akomakom/esp32-spa-controller/(threads)

Thread 1 (2025-04-20):

Options to be used as controller fro  Davey/Spa-Quip Spa Power PCB - SP600/601

robouden, 2025-04-20:
Hi,

Great project!!!. One question. How hard will it be to adopt the hardware and software to work with a Davey/Spa-Quip Spa Power PCB - SP600/601 setup?

Warm Regards
Rob Oudendijk

alexander-komarov-ibm, 2025-04-20:
No idea.  Is it an ESP powered board with one relay per output pin?  Then not very hard.
Ultimately the code could adapt to anything with enough effort, but I've only done just enough to make it work for my use case (a $20 ESP board with integrated relays wired as shown in the diagram here https://github.com/akomakom/esp32-spa-controller/blob/master/controller%2FREADME.md ).

akomakom, 2025-04-20:
No idea. Is it an ESP powered board with one relay per output pin? Then not very hard.
Ultimately the code could adapt to anything with enough effort, but I've only done just enough to make it work for my use case (a $20 ESP board with integrated relays wired as shown in the diagram here https://github.com/akomakom/esp32-spa-controller/blob/master/controller%2FREADME.md ).

robouden, 2025-04-20:
Thanks for the reply. No, the controller MPU is a ATMEGA08A. Closed source (as far as I know). The heater element is here [https://t.ly/puG-T](https://t.ly/puG-T) and the controller board is [https://www.hottubpartsuperstore.co.uk/davey-spa-quip-spa-power-pcb-sp600-sp601.html](https://www.hottubpartsuperstore.co.uk/davey-spa-quip-spa-power-pcb-sp600-sp601.html).

Regards
Rob
