akomakom/esp32-spa-controller/controller/controller.ino

#include <WiFi.h>
#include <WiFiClient.h>
//#include <WebServer.h>
#include <ESPmDNS.h>
#include <DNSServer.h>
#include <ArduinoJson.h>
#include "freertos/FreeRTOS.h"
#include "freertos/queue.h"

#include "secrets.h"
#include "web.h"
#include "HotTubUtils.h"
#include "ESPNowUtils.h"
#ifdef ENABLE_BLE_BTHOME
#include "BTHomeUtils.h"
#endif

// Hostname advertised over mDNS: reach the controller at http://<name>.local on the
// home network instead of hunting for a DHCP-assigned IP. Override in secrets.h.
#ifndef MDNS_HOSTNAME
#define MDNS_HOSTNAME "hottub"
#endif

// Captive-portal DNS: while the SoftAP is up we answer every DNS query with the AP's
// own IP, so joining the "hottubctl" network pops the control page up automatically
// (no need to type 192.168.4.1).
static const byte DNS_PORT = 53;
DNSServer dnsServer;

// Interval at which to publish sensor readings
#define ESP_STATUS_SEND_INTERVAL  1000

#define NTP_SYNC_INTERVAL 3600 * 1000
// If we don't get NTP sync success for this long, reboot (assume that network failed)
#define NTP_SYNC_FAIL_REBOOT_INTERVAL NTP_SYNC_INTERVAL * 24

// TimeZone rule including daylight adjustment rules (optional)
// TODO: move to Preferences
const char* time_zone = "EST5EDT,M3.2.0,M11.1.0";
const char* ntpServer1 = "pool.ntp.org";
const char* ntpServer2 = "time.nist.gov";
unsigned long  ntp_last_sync_success_time = 0;

SpaStatus spaStatus;
// Stores last time status was published on esp-now
unsigned long previousStatusSendTime = 0;

// Commands arrive on the ESP-NOW receive callback (WiFi task context). Rather than
// mutate control state there — racing the main loop — we queue them and drain in loop().
QueueHandle_t commandQueue;
#define COMMAND_QUEUE_DEPTH 10

void setDeviceTime(){
    static unsigned long lastPrint;
    bool debug = ((lastPrint + 10000) < millis());
    if (debug) {
        lastPrint = millis();
    }

    if(!getLocalTime(main_device_time, 9)){
        if ((lastPrint + 10000) < millis()) {
            Serial.println("No time available (yet)");
            lastPrint = millis();
        }
        return;
    }
    if (debug) {
        Serial.println(main_device_time, "Determined time: %A, %B %d %Y %H:%M:%S");
    }
//    static time_t t = mktime(main_device_time);
//    struct timeval now = { .tv_sec = t };
    // this seems to be causing time to stand still:
//    settimeofday(&now, NULL); // is this even useful?

    // calculate timezone offset

    static struct tm  linfo, ginfo;
    static time_t  rawt;
    time( &rawt );
    gmtime_r( &rawt, &ginfo);
    localtime_r( &rawt, &linfo);

    time_t g = mktime(&ginfo);
    time_t l = mktime(&linfo);

    static int    offsetSeconds = difftime( l, g );
    static int    offsetHours   = (int)offsetSeconds /(60*60);
    // for our globals, we care about actual time offset (including DST)
    timezone_offset = linfo.tm_isdst ? offsetSeconds + 3600 : offsetSeconds;
    // print out debugs every minute
    if ((lastPrint + 60000) < millis()) {
//        Serial.printf("Setting time to %s\n", asctime(main_device_time));
        Serial.printf("Timezone offset is %d hour%s (%d seconds), %s  current offset is %d hour%s (%d seconds)\n\n",
                      offsetHours,
                      (offsetHours > 1 || offsetHours < -1) ? "s" : "",
                      offsetSeconds,
                      linfo.tm_isdst ? "DST in effect" : "DST not in effect",
                      linfo.tm_isdst ? offsetHours + 1 : offsetHours,
                      ((offsetHours + 1) > 1 || (offsetHours + 1) < -1) ? "s" : "",
                      timezone_offset
                      );

//        Serial.printf("Device time: %d\n", rawt);
        lastPrint = millis();
    }
}

// Callback function (get's called when time adjusts via NTP)
void timeavailable(struct timeval *t)
{
    Serial.println("Got time adjustment from NTP!");
    setDeviceTime();
    ntp_last_sync_success_time = millis();
}

void setupNTP() {
    sntp_set_time_sync_notification_cb( timeavailable );
    sntp_set_sync_interval(NTP_SYNC_INTERVAL) ; // This is probably default, but I want to make sure it's set to an hour.
    /**
     * NTP server address could be aquired via DHCP,
     *
     * NOTE: This call should be made BEFORE esp32 aquires IP address via DHCP,
     * otherwise SNTP option 42 would be rejected by default.
     * NOTE: configTime() function call if made AFTER DHCP-client run
     * will OVERRIDE aquired NTP server address
     */
//    sntp_servermode_dhcp(1);    // (optional)

    /**
     * This will set configured ntp servers and constant TimeZone/daylightOffset
     * should be OK if your time zone does not need to adjust daylightOffset twice a year,
     * in such a case time adjustment won't be handled automagicaly.
     */
//    configTime(gmtOffset_sec, daylightOffset_sec, ntpServer1, ntpServer2);

    /**
     * A more convenient approach to handle TimeZones with daylightOffset
     * would be to specify a environmnet variable with TimeZone definition including daylight adjustmnet rules.
     * A list of rules for your zone could be obtained from https://github.com/esp8266/Arduino/blob/master/cores/esp8266/TZ.h
     */
    configTzTime(time_zone, ntpServer1, ntpServer2);
}

void setupWIFI() {

    // delete old config
    WiFi.disconnect(true);

    delay(1000);

    WiFi.onEvent(WiFiStationConnected, WiFiEvent_t::ARDUINO_EVENT_WIFI_STA_CONNECTED);
    WiFi.onEvent(WiFiGotIP, WiFiEvent_t::ARDUINO_EVENT_WIFI_STA_GOT_IP);
    WiFi.onEvent(WiFiStationDisconnected, WiFiEvent_t::ARDUINO_EVENT_WIFI_STA_DISCONNECTED);

    // To support ESP-NOW
    // Set the device as a Station and Soft Access Point simultaneously
    WiFi.mode(WIFI_AP_STA);
    // Advertise a DHCP hostname *before* connecting so the router registers it. Many
    // home routers then resolve http://<name> (or <name>.lan) on the LAN — which,
    // unlike mDNS/.local, actually works from Android and Linux browsers.
    WiFi.setHostname(MDNS_HOSTNAME);
    // Connect to WiFi network
    if (app_preferences.isKey("wifi_ssid")) {
      WiFi.begin(app_preferences.getString("wifi_ssid"), app_preferences.getString("wifi_pass"));
      Serial.printf("WiFi begin called, connecting to %s", app_preferences.getString("wifi_ssid").c_str());
    } else {
      Serial.println("WiFi not configured yet, not starting.");
    }
    delay(1000);
}

void setupSoftAP() {
    //
    WiFi.softAP(SOFTAP_WIFI_NAME, SOFTAP_WIFI_PASS);
    Serial.printf("Software Access Point available at %s/%s", SOFTAP_WIFI_NAME, SOFTAP_WIFI_PASS == NULL ? "(NOT SET)": SOFTAP_WIFI_PASS);

    // Resolve every hostname to the SoftAP IP so phones detect a captive portal and
    // open the control/setup page automatically on joining the network.
    dnsServer.setErrorReplyCode(DNSReplyCode::NoError);
    dnsServer.start(DNS_PORT, "*", WiFi.softAPIP());
    Serial.printf("Captive portal DNS started on %s\n", WiFi.softAPIP().toString().c_str());
}

//
//void handleRequest()
//{
//  if (server.method() == HTTP_POST) {
//    strncpy(wiFiCredentials.ssid, server.arg("ssid").c_str(), sizeof(wiFiCredentials.ssid));
//    strncpy(wiFiCredentials.password, server.arg("password").c_str(), sizeof(wiFiCredentials.password));
//
//    wiFiCredentials.ssid[server.arg("ssid").length()] = wiFiCredentials.password[server.arg("password").length()] = 0;
//
//    EEPROM.put(0, wiFiCredentials);
//    EEPROM.commit();
//
//    const char * content = "<html><head> <link rel=\"stylesheet\" href=\"https://netdna.bootstrapcdn.com/bootstrap/3.0.2/css/bootstrap.min.css\"> <style>body{background: #eee !important;}.wrapper{margin-top: 80px; margin-bottom: 80px;}.form-signin, .result-message{max-width: 380px; padding: 15px 35px 45px; margin: 0 auto; background-color: #fff; border: 1px solid rgba(0, 0, 0, 0.1);}.form-signin .form-signin-heading{margin-bottom: 30px;}.form-signin .form-control{position: relative; font-size: 16px; height: auto; padding: 10px; -webkit-box-sizing: border-box; -moz-box-sizing: border-box; box-sizing: border-box;}.form-signin .form-control:focus{z-index: 2;}.form-signin input[type=text]{margin-bottom: -1px; border-bottom-left-radius: 0; border-bottom-right-radius: 0;}.form-signin input[type=password]{margin-bottom: 20px; border-top-left-radius: 0; border-top-right-radius: 0;}.result-message{text-align: center;}</style></head><body> <div class=\"wrapper\"> <div class=\"result-message\"> The Wi-Fi credentials have been stored. <br/> Please reboot the device! </div></div></body></html> ";
//    server.send(200, "text/html", content);
//  } else {
//    const char * formHtml = "<html><head> <link rel=\"stylesheet\" href=\"https://netdna.bootstrapcdn.com/bootstrap/3.0.2/css/bootstrap.min.css\"> <style>body{background: #eee !important;}.wrapper{margin-top: 80px; margin-bottom: 80px;}.form-signin{max-width: 380px; padding: 15px 35px 45px; margin: 0 auto; background-color: #fff; border: 1px solid rgba(0, 0, 0, 0.1);}.form-signin .form-signin-heading{margin-bottom: 30px;}.form-signin .form-control{position: relative; font-size: 16px; height: auto; padding: 10px; -webkit-box-sizing: border-box; -moz-box-sizing: border-box; box-sizing: border-box;}.form-signin .form-control:focus{z-index: 2;}.form-signin input[type=text]{margin-bottom: -1px; border-bottom-left-radius: 0; border-bottom-right-radius: 0;}.form-signin input[type=password]{margin-bottom: 20px; border-top-left-radius: 0; border-top-right-radius: 0;}</style></head><body> <div class=\"wrapper\"> <form class=\"form-signin\" method=\"POST\"> <h2 class=\"form-signin-heading\">Connect To Wi-Fi</h2> <input type=\"text\" class=\"form-control\" name=\"ssid\" placeholder=\"SSID\" required=\"\" autofocus=\"\"/> <input type=\"password\" class=\"form-control\" name=\"password\" placeholder=\"Password\" required=\"\"/> <button class=\"btn btn-lg btn-primary btn-block\" type=\"submit\">Save</button> </form> </div></body></html> ";
//    server.send(200, "text/html", formHtml);
//  }
//}

void setup(void) {
    Serial.begin(115200);

    if (!app_preferences.begin(PREFERENCES_NAME)) {
        Serial.println("Unable to open preferences");
    }
    spaWinterized = app_preferences.getBool("winterized", false); // persists across reboots
    if (spaWinterized) {
        Serial.println("WINTERIZED mode is ON at boot: all controls forced off.");
    }

    commandQueue = xQueueCreate(COMMAND_QUEUE_DEPTH, sizeof(struct_command));

    setupNTP();
    setupSoftAP();
    setupWIFI();

    // mDNS is (re)started from the WiFiGotIP event, once the STA actually has an IP,
    // so the responder binds to the LAN interface and not just the SoftAP.

    SPIFFS.begin();

    server.on("/status", HTTP_GET, []() {
        spaStatus.updateStatusString();
        sendJSONResponse(spaStatus.statusString);
    });

    server.on("/toggle", HTTP_POST, []() {
        const char *response = WEB_RESPONSE_OK;
        try {
            spaStatus.findByName(server.arg("control").c_str())->toggle();
            previousStatusSendTime = 0; // update all others
            sendJSONResponse(WEB_RESPONSE_OK);
        } catch (std::invalid_argument &e) {
            sendJSONResponse(e.what(), 500);
        }
    });
    server.on("/override", HTTP_POST, []() {
        try {
            // seconds relative to current time
            time_t start    = (time_t)server.arg("start").toInt();
            time_t duration = (time_t)server.arg("duration").toInt();
            u_int8_t value = (u_int8_t)server.arg("value").toInt();
            spaStatus.findByName(server.arg("control").c_str())->applyUserValue(start, duration, value);
            previousStatusSendTime = 0; //update all others
            sendJSONResponse(WEB_RESPONSE_OK);
        } catch (std::invalid_argument &e) {
            sendJSONResponse(e.what(), 500);
        }
    });
    // Display/temperature unit is authoritative on the controller and pushed to the
    // display over ESP-NOW. 0 = Fahrenheit, 1 = Celsius.
    server.on("/tempUnit", HTTP_POST, []() {
        u_int8_t unit = (u_int8_t)server.arg("unit").toInt() ? 1 : 0;
        app_preferences.putUChar("temp_unit", unit);
        previousStatusSendTime = 0; // push the new unit to peers promptly
        sendJSONResponse(WEB_RESPONSE_OK);
    });
    // Winterized mode: force all controls off (ignoring schedules), persisted across
    // reboots and pushed to the display over ESP-NOW.
    server.on("/winterize", HTTP_POST, []() {
        spaWinterized = server.arg("on").toInt() ? true : false;
        app_preferences.putBool("winterized", spaWinterized);
        previousStatusSendTime = 0; // push the new state to peers promptly
        sendJSONResponse(WEB_RESPONSE_OK);
    });
    server.on("/configureControl", HTTP_GET, []() {
        SpaControl *control = spaStatus.findByName(server.arg("control").c_str());
        control->updateConfigJsonString();
        sendJSONResponse(control->configString);
    });
    // Body: control=<name>, overrideDefaultDurationSeconds=<n>, and periods=<json array>
    // e.g. periods=[{"startHour":0,"onMinutes":5,"cycleMinutes":15,"onValue":1,"offValue":0}, ...]
    server.on("/configureControl", HTTP_POST, []() {
        try {
            SpaControl *control = spaStatus.findByName(server.arg("control").c_str());

            StaticJsonDocument<800> doc;
            DeserializationError err = deserializeJson(doc, server.arg("periods"));
            if (err) {
                sendJSONResponse("Invalid periods JSON", 400);
                return;
            }
            JsonArray arr = doc.as<JsonArray>();
            SpaSchedulePeriod periods[MAX_SCHEDULE_PERIODS];
            u_int8_t count = 0;
            for (JsonObject o : arr) {
                if (count >= MAX_SCHEDULE_PERIODS) break;
                periods[count].startHour    = (u_int8_t) o["startHour"].as<int>();
                periods[count].onMinutes    = (u_int16_t)o["onMinutes"].as<int>();
                periods[count].cycleMinutes = (u_int16_t)o["cycleMinutes"].as<int>();
                periods[count].onValue      = (u_int8_t) o["onValue"].as<int>();
                periods[count].offValue     = (u_int8_t) o["offValue"].as<int>();
                count++;
            }
            if (count >= 1) {
                control->setSchedule(periods, count); // sorts, clamps, forces first to 00:00
            }
            if (server.hasArg("overrideDefaultDurationSeconds")) {
                control->scheduleSettings.overrideDefaultDurationSeconds =
                        (u_int32_t)server.arg("overrideDefaultDurationSeconds").toInt();
            }
            control->persist();
            previousStatusSendTime = 0; // update others
            sendJSONResponse(WEB_RESPONSE_OK);
        } catch (std::invalid_argument &e) {
            sendJSONResponse(e.what(), 500);
        }
    });

    setupServerDefaultActions();
    server.begin();

    spaStatus.setup();
    ESPNowUtils::setup();
#ifdef ENABLE_BLE_BTHOME
    // BLE BTHome broadcast of telemetry (water temp for now). Started after WiFi/ESP-NOW
    // so the radio coexistence layer is already up. See BTHomeUtils.h. Opt-in build flag.
    BTHomeUtils::setup("Hot Tub");
#endif
    ESPNowUtils::registerCommandCallBackHandler((ESPNowUtils::hot_tub_command_recv_callback)espnowCommandReceived);
    ESPNowUtils::registerPairingCallBackHandler((ESPNowUtils::hot_tub_paired_callback)peerAdded);

}

void loop(void) {
    static unsigned long lastHttpReportTime = 0;
    static unsigned long lastTimeUpdate = 0;

    // setDeviceTime() calls getLocalTime(..., 9), which blocks for the full 9ms whenever
    // the clock is not NTP-synced (e.g. during SoftAP setup, before any home WiFi is set).
    // Running it every loop throttles the loop to ~100Hz, which starves the captive-portal
    // DNS and single-threaded WebServer once wildcard DNS funnels all client traffic at us.
    // Second-resolution time is plenty for scheduling, so update it at most once a second.
    if (millis() - lastTimeUpdate >= 1000) {
        lastTimeUpdate = millis();
        setDeviceTime();
    }
    dnsServer.processNextRequest();
    server.handleClient();
    processCommandQueue();
    spaStatus.loop();
    ESPNowUtils::loop();
    sendStatus();
#ifdef ENABLE_BLE_BTHOME
    // Feed the latest water-temp reading to the BLE beacon; loop() throttles publishing.
    BTHomeUtils::setWaterTemp(spaStatus.temperatureUtils.getTempF(0),
                              spaStatus.temperatureUtils.isValid(0));
    BTHomeUtils::loop();
#endif
    yield();
//    sleep(5);

#ifdef REPORT_SEND_FREQUENCY
    if (WiFi.status() == WL_CONNECTED && (millis() - lastHttpReportTime) > REPORT_SEND_FREQUENCY) {
      sendStatusViaHttp(REPORT_SEND_URL, spaStatus.statusString);
      lastHttpReportTime = millis();
    }
#endif
    // reboot check
    if ((millis() - ntp_last_sync_success_time) > NTP_SYNC_FAIL_REBOOT_INTERVAL) {
        Serial.printf("We have not seen an NTP update in over %d, assuming network broke, rebooting", NTP_SYNC_FAIL_REBOOT_INTERVAL);
        ESP.restart();
    }
}

void peerAdded(struct_pairing pairing) {
    previousStatusSendTime = 0; // update others
}

void sendStatus() {
    unsigned long currentMillis = millis();
    if (currentMillis - previousStatusSendTime >= ESP_STATUS_SEND_INTERVAL) {
        // Save the last time a new reading was published
        previousStatusSendTime = currentMillis;

        ESPNowUtils::outgoingStatusServer.time = mktime(main_device_time);
        ESPNowUtils::outgoingStatusServer.tz_offset = timezone_offset;
        // Native unit is Fahrenheit; the display converts for presentation.
        ESPNowUtils::outgoingStatusServer.water_temp = spaStatus.temperatureUtils.getTempF(0);
        ESPNowUtils::outgoingStatusServer.temp_unit = app_preferences.getUChar("temp_unit", 0);
        ESPNowUtils::outgoingStatusServer.winterized = spaWinterized ? 1 : 0;
        ESPNowUtils::outgoingStatusServer.control_count = spaStatus.controls.size();
        ESPNowUtils::outgoingStatusServer.touchscreen_timeout = 300;

        // TODO:
//        ESPNowUtils::outgoingStatusServer.server_name =

        ESPNowUtils::sendStatusServer();

        for (int i = 0 ; i < spaStatus.controls.size() ; i++) {
            yield(); // this really slows down updates
            delay(1);
            SpaControl* control = spaStatus.controls[i];
            ESPNowUtils::outgoingStatusControl.control_id = i;
            ESPNowUtils::outgoingStatusControl.min = control->min;
            ESPNowUtils::outgoingStatusControl.max = control->max;
            strcpy(ESPNowUtils::outgoingStatusControl.type, control->type);
            strcpy(ESPNowUtils::outgoingStatusControl.name, control->name);
            ESPNowUtils::outgoingStatusControl.ORT = control->getOverrideScheduleRemainingTime();
            ESPNowUtils::outgoingStatusControl.DO = control->scheduleSettings.overrideDefaultDurationSeconds;
            ESPNowUtils::outgoingStatusControl.EL = control->getOverrideScheduleElapsedTime();

            ESPNowUtils::outgoingStatusControl.value = control->getEffectiveValue();
            ESPNowUtils::outgoingStatusControl.e_value = control->getOnState();

            ESPNowUtils::sendStatusControl();
        }
    }
}

/**
 * Handle incoming commands received via ESP-NOW.
 * Runs in the WiFi task context, so we only enqueue here and apply from loop().
 * @param command
 */
void espnowCommandReceived(struct_command *command) {
    Serial.print("Received command: control=");Serial.print(command->control_id);
    Serial.print(" value=");Serial.print(command->value);
    Serial.print(" end=");Serial.print(command->end);
    Serial.println();

    if (commandQueue != NULL) {
        xQueueSend(commandQueue, command, 0); // copies the struct; drop if queue is full
    }
}

/**
 * Drain and apply any commands queued by the ESP-NOW receive callback.
 * Runs on the main loop, so it is safe to mutate control state here.
 */
void processCommandQueue() {
    struct_command command;
    while (commandQueue != NULL && xQueueReceive(commandQueue, &command, 0) == pdTRUE) {
        if (command.control_id >= spaStatus.controls.size()) {
            Serial.printf("Ignoring command for out-of-range control_id %d\n", command.control_id);
            continue;
        }
        previousStatusSendTime = 0; // update others
        try {
            spaStatus.controls[command.control_id]->applyUserValue(
                    command.start,
                    command.end,
                    command.value
            );
        } catch (std::invalid_argument &e) {
            Serial.printf("Rejected command for control %d: %s\n", command.control_id, e.what());
        }
    }
}


// WIFI:

void WiFiStationConnected(WiFiEvent_t event, WiFiEventInfo_t info){
    Serial.println("Connected to AP successfully!");
    Serial.println("");

    Serial.print("Connected to ");
    Serial.print(app_preferences.getString("wifi_ssid"));
}

void WiFiGotIP(WiFiEvent_t event, WiFiEventInfo_t info){
    Serial.println("WiFi connected");
    Serial.println("IP address: ");
    Serial.println(WiFi.localIP());

    // (Re)start mDNS now that the STA has an IP so the responder binds to the LAN
    // interface. Restart on every reconnect so it re-announces after the link drops.
    static bool mdnsStarted = false;
    if (mdnsStarted) {
        MDNS.end();
    }
    if (MDNS.begin(MDNS_HOSTNAME)) {
        MDNS.addService("http", "tcp", 80);
        mdnsStarted = true;
        Serial.printf("mDNS responder started: http://%s.local\n", MDNS_HOSTNAME);
    } else {
        Serial.println("Error setting up mDNS responder!");
    }
}

void WiFiStationDisconnected(WiFiEvent_t event, WiFiEventInfo_t info){
    Serial.println("Disconnected from WiFi access point");
    Serial.print("WiFi lost connection. Reason: ");
    Serial.println(info.wifi_sta_disconnected.reason);
    Serial.println("Trying to Reconnect");
    WiFi.begin(app_preferences.getString("wifi_ssid"), app_preferences.getString("wifi_pass"));

}
