akomakom/esp32-spa-controller/controller/web.cpp

#include <WiFi.h>
#include "core.h"
#include "web.h"
#include "secrets.h"

// Credentials for firmware / filesystem / WiFi endpoints. Override in secrets.h.
#ifndef OTA_AUTH_USER
#define OTA_AUTH_USER "admin"
#endif
#ifndef OTA_AUTH_PASS
#define OTA_AUTH_PASS "admin"
#endif

// Gate sensitive endpoints behind HTTP Basic auth. Returns false (and sends a 401)
// when the request is not authenticated, so callers can simply `if (!requireAuth()) return;`.
bool requireAuth() {
    if (!server.authenticate(OTA_AUTH_USER, OTA_AUTH_PASS)) {
        server.requestAuthentication();
        return false;
    }
    return true;
}

// Hostname advertised over mDNS (keep in sync with controller.ino). Requests whose
// Host header matches this, the SoftAP IP, or the STA IP are treated as direct visits;
// anything else arriving on the SoftAP is an OS captive-portal probe.
#ifndef MDNS_HOSTNAME
#define MDNS_HOSTNAME "hottub"
#endif

const char *WEB_RESPONSE_OK = R"({ "success": true })";
const char *WEB_RESPONSE_FAIL = R"({ "success": false })";

// When a phone joins the SoftAP, the OS probes a known URL (captive.apple.com,
// connectivitycheck.gstatic.com, msftconnecttest.com, ...). Because our captive DNS
// resolves every name to the AP IP, those probes land here with a foreign Host header.
// Answering with a 302 to the control page makes the OS pop up the captive-portal browser
// automatically. Returns true if it handled (redirected) the request.
bool handleCaptivePortal() {
    String host = server.hostHeader();
    String apIP = WiFi.softAPIP().toString();
    String staIP = WiFi.localIP().toString();
    if (host == apIP ||
        (staIP.length() && staIP != "0.0.0.0" && host == staIP) ||
        host.equalsIgnoreCase(String(MDNS_HOSTNAME) + ".local")) {
        return false; // direct visit to a known address — serve normally
    }
    server.sendHeader("Location", String("http://") + apIP + "/", true);
    server.send(302, "text/plain", "");
    return true;
}

/*
 * Login page
 */

const char *WEBPAGE_LOGIN =
        "<form name='loginForm'>"
        "<table width='20%' bgcolor='A09F9F' align='center'>"
        "<tr>"
        "<td colspan=2>"
        "<center><font size=4><b>ESP32 Login Page AKOM</b></font></center>"
        "<br>"
        "</td>"
        "<br>"
        "<br>"
        "</tr>"
        "<tr>"
        "<td>Username:</td>"
        "<td><input type='text' size=25 name='userid'><br></td>"
        "</tr>"
        "<br>"
        "<br>"
        "<tr>"
        "<td>Password:</td>"
        "<td><input type='Password' size=25 name='pwd'><br></td>"
        "<br>"
        "<br>"
        "</tr>"
        "<tr>"
        "<td><input type='submit' onclick='check(this.form)' value='Login'></td>"
        "</tr>"
        "</table>"
        "</form>"
        "<script>"
        "function check(form)"
        "{"
        "if(form.userid.value=='admin' && form.pwd.value=='admin')"
        "{"
        "window.open('/serverIndex')"
        "}"
        "else"
        "{"
        " alert('Error Password or Username')/*displays error message*/"
        "}"
        "}"
        "</script>";

/*
 * Server Index Page
 */

const char *WEBPAGE_UPDATE =
        "<script src='https://ajax.googleapis.com/ajax/libs/jquery/3.2.1/jquery.min.js'></script>"
        "<form method='POST' action='#' enctype='multipart/form-data' id='upload_form'>"
        "<input type='file' name='update'>"
        "<input type='submit' value='Update'>"
        "</form>"
        "<div id='prg'>progress: 0%</div>"
        "<script>"
        "$('form').submit(function(e){"
        "e.preventDefault();"
        "var form = $('#upload_form')[0];"
        "var data = new FormData(form);"
        " $.ajax({"
        "url: '/update',"
        "type: 'POST',"
        "data: data,"
        "contentType: false,"
        "processData:false,"
        "xhr: function() {"
        "var xhr = new window.XMLHttpRequest();"
        "xhr.upload.addEventListener('progress', function(evt) {"
        "if (evt.lengthComputable) {"
        "var per = evt.loaded / evt.total;"
        "$('#prg').html('progress: ' + Math.round(per*100) + '%');"
        "}"
        "}, false);"
        "return xhr;"
        "},"
        "success:function(d, s) {"
        "console.log('success!')"
        "},"
        "error: function (a, b, c) {"
        "}"
        "});"
        "});"
        "</script>";

//holds the current upload
File fsUploadFile;

void sendJSONResponse(const char *content) {
    sendJSONResponse(content, 200);
}

void sendJSONResponse(const char *content, int code) {
    server.sendHeader("Connection", "close");
    server.send(code, "application/json", content);
}

void sendHTMLResponse(const char *content) {
    server.sendHeader("Connection", "close");
    server.send(200, "text/html", content);
}

void returnFail(String msg) {
    server.send(500, "text/plain", msg + "\r\n");
}

String getContentType(String filename){
    if(server.hasArg("download")) return "application/octet-stream";
    else if(filename.endsWith(".htm")) return "text/html";
    else if(filename.endsWith(".html")) return "text/html";
    else if(filename.endsWith(".css")) return "text/css";
    else if(filename.endsWith(".js")) return "application/javascript";
    else if(filename.endsWith(".png")) return "image/png";
    else if(filename.endsWith(".gif")) return "image/gif";
    else if(filename.endsWith(".jpg")) return "image/jpeg";
    else if(filename.endsWith(".ico")) return "image/x-icon";
    else if(filename.endsWith(".xml")) return "text/xml";
    else if(filename.endsWith(".pdf")) return "application/x-pdf";
    else if(filename.endsWith(".zip")) return "application/x-zip";
    else if(filename.endsWith(".gz")) return "application/x-gzip";
    return "text/plain";
}

bool handleFileRead(String path){
    Serial.println("handleFileRead: " + path);
    if(path.endsWith("/")) path += "index.html";
    String contentType = getContentType(path);
    String pathWithGz = path + ".gz";
    if(SPIFFS.exists(pathWithGz) || SPIFFS.exists(path)){
        if(SPIFFS.exists(pathWithGz))
            path += ".gz";
        File file = SPIFFS.open(path, "r");
        size_t sent = server.streamFile(file, contentType);
        file.close();
        return true;
    }
    return false;
}

void handleFileUpload(){
    if(server.uri() != "/edit") return;
    if(!server.authenticate(OTA_AUTH_USER, OTA_AUTH_PASS)) return;
    HTTPUpload& upload = server.upload();
    if(upload.status == UPLOAD_FILE_START){
        String filename = upload.filename;
        if(!filename.startsWith("/")) filename = "/"+filename;
        DBG_OUTPUT_PORT.print("handleFileUpload Name: "); DBG_OUTPUT_PORT.println(filename);
        fsUploadFile = SPIFFS.open(filename, "w");
        filename = String();
    } else if(upload.status == UPLOAD_FILE_WRITE){
        //DBG_OUTPUT_PORT.print("handleFileUpload Data: "); DBG_OUTPUT_PORT.println(upload.currentSize);
        if(fsUploadFile)
            fsUploadFile.write(upload.buf, upload.currentSize);
    } else if(upload.status == UPLOAD_FILE_END){
        if(fsUploadFile)
            fsUploadFile.close();
        DBG_OUTPUT_PORT.print("handleFileUpload Size: "); DBG_OUTPUT_PORT.println(upload.totalSize);
    }
}

void handleFileDelete(){
    if(server.args() == 0) return server.send(500, "text/plain", "BAD ARGS");
    String path = server.arg(0);
    DBG_OUTPUT_PORT.println("handleFileDelete: " + path);
    if(path == "/")
        return server.send(500, "text/plain", "BAD PATH");
    if(!SPIFFS.exists(path))
        return server.send(404, "text/plain", "FileNotFound");
    SPIFFS.remove(path);
    server.send(200, "text/plain", "");
    path = String();
}

void handleFileCreate(){
    if(server.args() == 0)
        return server.send(500, "text/plain", "BAD ARGS");
    String path = server.arg(0);
    DBG_OUTPUT_PORT.println("handleFileCreate: " + path);
    if(path == "/")
        return server.send(500, "text/plain", "BAD PATH");
    if(SPIFFS.exists(path))
        return server.send(500, "text/plain", "FILE EXISTS");
    File file = SPIFFS.open(path, "w");
    if(file)
        file.close();
    else
        return server.send(500, "text/plain", "CREATE FAILED");
    server.send(200, "text/plain", "");
    path = String();
}

void handleFileList() {
    if(!server.hasArg("dir")) {
        returnFail("BAD ARGS");
        return;
    }
    String path = server.arg("dir");
    if(path != "/" && !SPIFFS.exists((char *)path.c_str())) {
        returnFail("BAD PATH");
        return;
    }
    File dir = SPIFFS.open((char *)path.c_str());
    path = String();
    if(!dir.isDirectory()){
        dir.close();
        returnFail("NOT DIR");
        return;
    }
    dir.rewindDirectory();

    String output = "[";
    for (int cnt = 0; true; ++cnt) {
        File entry = dir.openNextFile();
        if (!entry)
            break;

        if (cnt > 0)
            output += ',';

        output += "{\"type\":\"";
        output += (entry.isDirectory()) ? "dir" : "file";
        output += "\",\"name\":\"";
        // Ignore '/' prefix
//        output += entry.name()+1;
        output += entry.name();
        output += "\"";
        output += "}";
        entry.close();
    }
    output += "]";
    server.send(200, "text/json", output);
    dir.close();
}

void listDir(fs::FS &fs, const char * dirname, uint8_t levels) {
    DBG_OUTPUT_PORT.printf("Listing directory: %s\n", dirname);

    File root = fs.open(dirname);
    if (!root) {
        DBG_OUTPUT_PORT.println("Failed to open directory");
        return;
    }
    if (!root.isDirectory()) {
        DBG_OUTPUT_PORT.println("Not a directory");
        return;
    }

    File file = root.openNextFile();
    while (file) {
        if (file.isDirectory()) {
            DBG_OUTPUT_PORT.print("  DIR : ");
            DBG_OUTPUT_PORT.println(file.name());
            if (levels) {
                listDir(fs, file.name(), levels - 1);
            }
        } else {
            DBG_OUTPUT_PORT.print("  FILE: ");
            DBG_OUTPUT_PORT.print(file.name());
            DBG_OUTPUT_PORT.print("  SIZE: ");
            DBG_OUTPUT_PORT.println(file.size());
        }
        file = root.openNextFile();
    }
}

void setupServerDefaultActions() {
    server.on("/serverIndex", HTTP_GET, []() {
        if (!requireAuth()) return;
        sendHTMLResponse(WEBPAGE_UPDATE);
    });
    server.on("/update", HTTP_GET, []() {
        if (!requireAuth()) return;
        sendHTMLResponse(WEBPAGE_UPDATE);
    });
    /*handling uploading firmware file */
    server.on("/update", HTTP_POST, []() {
        if (!requireAuth()) return;
        server.sendHeader("Connection", "close");
        server.send(200, "text/plain", (Update.hasError()) ? "FAIL" : "OK");
        ESP.restart();
    }, []() {
        // Runs while the request body streams in, before the completion handler above.
        // Refuse to touch flash unless authenticated.
        if (!server.authenticate(OTA_AUTH_USER, OTA_AUTH_PASS)) return;
        HTTPUpload &upload = server.upload();
        if (upload.status == UPLOAD_FILE_START) {
            Serial.printf("Update: %s\n", upload.filename.c_str());
            if (!Update.begin(UPDATE_SIZE_UNKNOWN)) { //start with max available size
                Update.printError(Serial);
            }
        } else if (upload.status == UPLOAD_FILE_WRITE) {
            /* flashing firmware to ESP*/
            if (Update.write(upload.buf, upload.currentSize) != upload.currentSize) {
                Update.printError(Serial);
            }
        } else if (upload.status == UPLOAD_FILE_END) {
            if (Update.end(true)) { //true to set the size to the current progress
                Serial.printf("Update Success: %u\nRebooting...\n", upload.totalSize);
            } else {
                Update.printError(Serial);
            }
        }
    });

    //load editor
    server.on("/edit", HTTP_GET, [](){
        if (!requireAuth()) return;
        if(!handleFileRead("/edit.htm")) server.send(404, "text/plain", "FileNotFound");
    });
    //create file
    server.on("/edit", HTTP_PUT, [](){ if (!requireAuth()) return; handleFileCreate(); });
    //delete file
    server.on("/edit", HTTP_DELETE, [](){ if (!requireAuth()) return; handleFileDelete(); });
    //first callback is called after the request has ended with all parsed arguments
    //second callback handles file uploads at that location
    server.on("/edit", HTTP_POST, [](){
        if (!requireAuth()) return;
        server.send(200, "text/plain", "");
    }, handleFileUpload);


    server.on("/list", HTTP_GET, [](){ if (!requireAuth()) return; handleFileList(); });

    server.on("/configureWifi", HTTP_POST, []() {
      if (!requireAuth()) return;
      Serial.printf("Configuring WiFi to %s/%s", server.arg("wifi_ssid").c_str(), server.arg("wifi_pass").c_str());
      app_preferences.putString("wifi_ssid", server.arg("wifi_ssid").c_str());
      app_preferences.putString("wifi_pass", server.arg("wifi_pass").c_str());
      Serial.printf("WIFI Configuration set to %s/%s, restarting", app_preferences.getString("wifi_ssid").c_str(), app_preferences.getString("wifi_pass").c_str());
      ESP.restart();
    });

    //called when the url is not defined here
    //use it to load content from SPIFFS
    server.onNotFound([](){
        // Redirect OS captive-portal probes to the control page (SoftAP visitors).
        if (handleCaptivePortal()) return;
        if(!handleFileRead(server.uri()))
            server.send(404, "text/plain", "FileNotFound");
    });
}


void sendStatusViaHttp(char* serverUrl, char* statusString) {

      httpClient.begin(serverUrl);  // HTTPS handled automatically
      httpClient.addHeader("Content-Type", "application/json");  // Specify JSON format

      // Send POST request
      int httpResponseCode = httpClient.POST(statusString);

      if (httpResponseCode > 0) {
          Serial.printf("HTTP Response code: %d\n", httpResponseCode);
          String response = httpClient.getString();
          Serial.println("Server response: " + response);
      } else {
          Serial.printf("HTTP POST failed: %s\n", httpClient.errorToString(httpResponseCode).c_str());
      }

      httpClient.end();  // Free resources
}


WebServer server(80);
HTTPClient httpClient;
