akomakom/esp32-spa-controller/controller/web.h

#ifndef __WEB_H__
#define __WEB_H__

#include <WebServer.h>
#include <HTTPClient.h>
#include <Update.h>
#include <SPIFFS.h>

#define DBG_OUTPUT_PORT Serial

extern const char *WEB_RESPONSE_OK;
extern const char *WEB_RESPONSE_FAIL;

extern const char *WEBPAGE_LOGIN;
extern const char *WEBPAGE_UPDATE;


extern void sendJSONResponse(const char *content);

extern void sendJSONResponse(const char *content, int code);

extern void sendHTMLResponse(const char *content);

extern void setupServerDefaultActions();

void sendStatusViaHttp(char* serverUrl, char* statusString);

extern WebServer server;

extern HTTPClient httpClient;


#endif
