akomakom/esp32-spa-controller/display/core.cpp

#include "core.h"


//Converts reason type to a C string.
//Type is located in /tools/sdk/esp32/include/esp_system/include/esp_system.h
const char *resetReasonName(esp_reset_reason_t r) {
  switch (r) {
    case ESP_RST_UNKNOWN:   return "Unknown";
    case ESP_RST_POWERON:   return "PowerOn";    //Power on or RST pin toggled
    case ESP_RST_EXT:       return "ExtPin";     //External pin - not applicable for ESP32
    case ESP_RST_SW:        return "Reboot";     //esp_restart()
    case ESP_RST_PANIC:     return "Crash";      //Exception/panic
    case ESP_RST_INT_WDT:   return "WDT_Int";    //Interrupt watchdog (software or hardware)
    case ESP_RST_TASK_WDT:  return "WDT_Task";   //Task watchdog
    case ESP_RST_WDT:       return "WDT_Other";  //Other watchdog
    case ESP_RST_DEEPSLEEP: return "Sleep";      //Reset after exiting deep sleep mode
    case ESP_RST_BROWNOUT:  return "BrownOut";   //Brownout reset (software or hardware)
    case ESP_RST_SDIO:      return "SDIO";       //Reset over SDIO
    default:                return "";
  }
}
