akomakom/esp32-spa-controller/controller/HotTubUtils.h

#include <sys/types.h>

#ifndef HOT_TUB_CONTROLLER_HOTTUBUTILS_H
#define HOT_TUB_CONTROLLER_HOTTUBUTILS_H

#include "esp32-hal-gpio.h"
#include <algorithm>

#include <vector>
#include "pgmspace.h"
#include <stdexcept>
#include <ArduinoJson.h>


#include "core.h"
#include "TemperatureUtils.h"


// needs to be large enough to allocate json document and string representation
#define STATUS_LENGTH 1000

// 8 channel relay ESP32-WROOM module from China:
const int RELAY_PIN_1 = 32;
const int RELAY_PIN_2 = 33;
const int RELAY_PIN_3 = 25;
const int RELAY_PIN_4 = 26;
const int RELAY_PIN_5 = 27;
const int RELAY_PIN_6 = 14;
const int RELAY_PIN_7 = 12;
const int RELAY_PIN_8 = 13;
const int LED_PIN = 23;



class SpaSensor {

};

class SpaControl; //forward declare

class SpaControlDependencies {
private:
    SpaControl* neededByOtherControl = NULL;
    u_int8_t neededByOtherControlValue;
    u_int8_t neededByOurValue;

    SpaControl* lockedToOtherControl = NULL;
    u_int8_t lockedToOtherControlValue;
    u_int8_t lockedToOurValue;

    static u_int8_t getDependencyValue(SpaControl* other, u_int8_t otherValue, u_int8_t ourValue);
public:
    static const u_int8_t SPECIAL_VALUE_ANY_GREATER_THAN_ZERO = 254;
    static const u_int8_t SPECIAL_RETURN_VALUE_NOT_IN_EFFECT = 255;

    /**
     * Declare that this control has a dependency and is needed by otherControl
     * This means that when otherControl's value is otherControlValue, our value should be ourValue.
     * This takes priority over normal schedule but not override schedule.
     *
     * eg: pump->neededBy(heater, 1, 1)
     * Pump should be on when heater wants to be on, in other words
     * pump value should be 1 when heater's value is 1, unless we're in override.
     * Ignore normal schedule during this time.
     *
     * @param otherControl pointer to control that needs our control
     * @param otherControlValue we only care obout otherControl's value when it's this
     * @param ourValue Change us to this value when these conditions are met
     */
    void neededBy(SpaControl* otherControl, u_int8_t otherControlValue, u_int8_t ourValue);

    /**
     * Similar to neededBy:
     *
     * ozone->lockedTo(pump, SPECIAL_VALUE_ANY_GREATER_THAN_ZERO, 1)
     * This means that whenever pump is on (any speed, value 1 or 2), ozone should be on.
     *
     * ozone->lockedTo(pump, 1, 1)
     * Ozone should be ON only when pump is in LOW speed.
     *
     *
     * @param otherControl
     * @param otherControlValue
     * @param ourValue
     */
    void lockedTo(SpaControl* otherControl, u_int8_t otherControlValue, u_int8_t ourValue);
    /**
     * @return value that the dependent control would like us to use, if configured and conditions are met,
     *  or SPECIAL_RETURN_VALUE_NOT_IN_EFFECT
     */
    u_int8_t getDependencyValue();

    /**
     * If either neededBy or lockedTo was called, returns the dependent control.
     * Otherwise, returns NULL.
     * @return
     */
    SpaControl* getDependentControl();
};


#define MAX_SCHEDULE_PERIODS 6
#define SCHEDULE_SETTINGS_VERSION 2

// One time-of-day period. Periods tile the day: a period runs from its startHour
// until the next period's startHour (the last runs to midnight). Within a period the
// control cycles: ON for the first onMinutes of every cycleMinutes window. When
// onMinutes >= cycleMinutes the control is always on (used for heater setpoints).
typedef struct {
    u_int8_t  startHour = 0;       // 0..23, when this period begins
    u_int16_t onMinutes = 0;       // ON duration at the start of each cycle
    u_int16_t cycleMinutes = 60;   // cycle length (>=1); onMinutes>=cycleMinutes => always on
    u_int8_t  onValue = 1;         // control value while ON (pump speed, heater setpoint, ...)
    u_int8_t  offValue = 0;        // control value while OFF
} SpaSchedulePeriod;

typedef struct {
    u_int8_t version = SCHEDULE_SETTINGS_VERSION; // for forward migration / validation
    u_int8_t periodCount = 1;                     // 1..MAX_SCHEDULE_PERIODS
    SpaSchedulePeriod periods[MAX_SCHEDULE_PERIODS];
    u_int32_t overrideDefaultDurationSeconds = 60 * 20; // 20 minutes default
} SpaScheduleSettings;

/**
 * A Scheduler that can be attached to any control
 * A control will consult the scheduler to see if the value should be schedule-based
 *
 * Scheduler supports two types of automation:
 * 1) Normal: On for a certain percentage of the day, every day.
 * 2) Override: Temporarily override the normal schedule (whether one is set or not), one time, for a set duration.
 *
 * For example, 2-speed pump scheduler:
 * - Pump on low for 50% of the day, in 5 segments = 10% on, 10% off, all day (2.4 hours on, 2.4 hours off):
 *      normalSchedule(50, 5, 1, 0);
 * - Override: someone pushed the Boost button (high speed): High Speed for 20 minutes, then back to above:
 *      scheduleOverride(now(), now() + 20 * SECS_PER_MIN, 2)
 *
 */
class SpaControlScheduler {
    const int DEFAULT_MIN = 0;
    const int DEFAULT_MAX = 1;
public:

    /**
     * Schedule on-time through the day.
     * @param percentageOfDayOnTime eg 50
     * @param numberOfTimesToRun eg 5, meaning run 50% in a 24 hour period, break up on-time into 5 segments
     * @param normalValueOn when in on phase, this should be the control's value
     * @param normalValueOff when in off phase, this should be the control's value
     */
    void normalSchedule(u_int8_t percentageOfDayOnTime, u_int8_t numberOfTimesToRun, u_int8_t normalValueOn, u_int8_t normalValueOff);

    /**
     * Replace the whole time-of-day schedule. Periods are sorted by startHour, the
     * first is forced to start at 00:00, count is clamped to [1, MAX_SCHEDULE_PERIODS],
     * and values are clamped to [min, max]. Does not persist (call persist() after).
     */
    void setSchedule(const SpaSchedulePeriod* newPeriods, u_int8_t count);

    /** Index of the period that covers the current time of day. */
    u_int8_t getCurrentPeriodIndex();

    /**
     *  Override normal schedule during this period
     * @param startTime
     * @param endTime
     * @param valueOverride
     */
    void scheduleOverride(time_t startTime, time_t endTime, u_int8_t valueOverride);

    void cancelOverride();
    /**
     *
     * @return true if override schedule (specifically) is in effect
     */
    bool isOverrideScheduleEnabled();

    /**
     *
     * @return remaining seconds or 0 if not in override mode
     */
    time_t getOverrideScheduleRemainingTime();

    /**
     *
     * @return seconds since override began or 0 if not in override mode
     */
    time_t getOverrideScheduleElapsedTime();
    /**
     * @return If override is enabled, returns overrideValue
     */
    u_int8_t getOverrideValue();
    /**
     * @return normalValueOn or normalValueOff otherwise
     */
    u_int8_t getScheduledValue();

    void updateConfigJsonString();

    void persist(const char* eepromKey);
    void load(const char* eepromKey);

    // min and max bounds for value, for arg checking
    u_int8_t min = DEFAULT_MIN;
    u_int8_t max = DEFAULT_MAX;


    char configString[700]; // for JSON output (holds the periods array)

    // When true this control only follows a "locked-to" dependency (e.g. ozone->pump)
    // while its own schedule is ON: the schedule ARMS it rather than running it directly,
    // and it is never turned on by the schedule alone. See SpaControl::getEffectiveValue().
    bool dependencyGatedBySchedule = false;

    SpaScheduleSettings scheduleSettings;

private:
    /**
     * Utility that will raise an exception for out of bounds
     * @param value
     */
    void checkBounds(u_int8_t value);

    static const u_int8_t SCHEDULER_DISABLED_VALUE = -1;

    time_t overrideStartTime = now();
    time_t overrideEndTime = now();
    u_int8_t overrideValue = SCHEDULER_DISABLED_VALUE;

    StaticJsonDocument<700> jsonConfig;
};

class SpaControl : public SpaControlScheduler, public SpaControlDependencies {
public:
    SpaControl(const char *name, const char *type);

    virtual void toggle();

    /**
     * Apply a value requested by a user (web or display).
     * @param relStart seconds from now the value should take effect
     * @param relEnd   seconds from now the value should stop
     * @param value    the requested value
     *
     * Base behaviour is a temporary override that reverts to the normal schedule.
     * SensorBasedControl overrides this to change the persistent setpoint instead,
     * so a heater temperature survives the override window and reboots.
     */
    virtual void applyUserValue(time_t relStart, time_t relEnd, u_int8_t value);

    /**
     *  This is the input value, eg on/off (1/0) or "100" for temperature.
     *  It can vary by scheduler/override
     * @return either this->value or this->scheduler value if scheduler is in effect
     */
    virtual u_int8_t getEffectiveValue();

    /**
     * For some cotrols (eg SensorBased), effective value doesn't translate to
     * "is on" very easily
     * @return The output state that is actually driving output pins.
     *      Same as getEffectiveValue() for simple control, on/off for SensorBased
     */
    virtual u_int8_t getOnState();

    /**
     * @return Usually same as getOnState() but may differ
     *  if delays are implemented (eg post delay for heater)
     */
    virtual u_int8_t getOnStateForDependents();

    virtual void applyOutputs();

    const char *name;
    const char *type;
    JsonObject jsonStatus;

    void persist();
    void load();

private:
    void init(const char *name, u_int8_t min, u_int8_t max);
    char persistKeyScheduler[20];

protected:
    u_int8_t getNextValue(); // helper for toggle()
};

class SimpleSpaControl : public SpaControl {
public:
    SimpleSpaControl(const char *name, u_int8_t pin);

    virtual void toggle();

    virtual void applyOutputs();

    u_int8_t pin;
};

/**
 * A two-relay wiring setup where one relay turns on power and the other (SPDT) relay
 * selects one of two speeds, eg for a pool pump.  Low is 1,0 and high is 1,1
 *
 */
class TwoSpeedSpaControl : public SpaControl {
public:
    TwoSpeedSpaControl(const char *name, u_int8_t pin_power, u_int8_t pin_speed);

    virtual void toggle();

    virtual void applyOutputs();

    u_int8_t pinPower;
    u_int8_t pinSpeed;
};

class SensorBasedControl: public SpaControl {
public:
    SensorBasedControl(const char *name, u_int8_t pin, u_int8_t sensorIndex, u_int8_t swing, time_t postShutdownStayOnUntil, TemperatureUtils* temps);
    virtual void applyOutputs();
    virtual u_int8_t getOnState();
    virtual u_int8_t getOnStateForDependents();

    // A sensor-based setpoint is persistent: it becomes the "on" value of the normal
    // schedule and is saved to NVS, rather than a temporary override.
    virtual void applyUserValue(time_t relStart, time_t relEnd, u_int8_t value);
    void setSetpoint(u_int8_t value);

    u_int8_t pin;
    u_int8_t sensorIndex;

    float swing; // +/- threshold before kicking on/off
    // The length of time to keep downstream controls on (eg pump) after shutdown
    // for example to extract heat from the heater
    time_t postShutdownOnTime = 0;

    TemperatureUtils* temperatureUtils;
private:
    time_t postShutdownStayOnUntil = 0; // we'll save a future time in here
    bool slowFlipState = false; // for swing feature

};

class SpaStatus {
private:
    StaticJsonDocument<STATUS_LENGTH> jsonStatus;
    JsonArray jsonStatusControls = jsonStatus.createNestedArray("controls");
    JsonObject jsonStatusMetrics = jsonStatus.createNestedObject("metrics");


public:
    SpaStatus();

    TemperatureUtils temperatureUtils;
    SpaControl* pump = new TwoSpeedSpaControl("pump", RELAY_PIN_1, RELAY_PIN_2);
    SpaControl* blower = new SimpleSpaControl("blower", RELAY_PIN_3);
    SpaControl* heater = new SensorBasedControl("heater", RELAY_PIN_4, 0, 1, 5*60, &temperatureUtils);
    SpaControl* ozone = new SimpleSpaControl("ozone", RELAY_PIN_5);
    SpaControl* light = new SimpleSpaControl("light", RELAY_PIN_6);

    // You may need to increase STATUS_LENGTH if adding more controls
    char statusString[STATUS_LENGTH];

    void updateStatusString();

    std::vector<SpaControl*> controls = {pump, blower, heater, ozone, light};

    SpaControl *findByName(const char *name);

    void setup();
    void loop();
};


#endif //HOT_TUB_CONTROLLER_HOTTUBUTILS_H
