akomakom/esp32-spa-controller/(commit log)

2023-06-18 Initial commit - buttons kinda work
2023-06-30 Switch to SPIFFs for HTML, arduino-cli Makefile
2023-07-10 Brought in display code that doesn't do much yet
    [controller.ino, display.ino, gfx.h, touch.h, web.cpp, web.h]
2023-07-14 1-wire temp support pass1
2023-07-18 Heater control
2023-07-18 preliminary sensor mapping code
2023-07-19 Correcting dependency logic for heater
    [HotTubUtils.cpp, HotTubUtils.h]
2023-07-19 Swing feature for heater control
2023-07-27 Rudimentary dynamic buttons
2023-08-03 Fix for midnight blip scheduler issue
    [HotTubUtils.cpp]
2023-08-04 Switch to native ESP NTP
2023-08-06 BL timeout, LED display, instant update.
2023-08-08 better touch map and heater temp dialog
2023-08-09 Move UI updates to lv_timer, fixes hangs
    [controller.ino, display.ino, touch.h]
2023-08-09 more use of timer, fix controller send delay
    [controller.ino, display.ino]
2023-08-11 a lot of fixes
    [HotTubUtils.cpp, TemperatureUtils.cpp, controller.ino, core.cpp, core.h, display.ino, gfx.h, hot_tub_types.h]
2023-09-15 Prevent accidental touch on wake-up
    [ESPNowUtils.cpp, gfx.h]
2023-10-10 Auto-reboot if no NTP updates in 2 hours
    [controller.ino, core.h]
2023-12-21 Leave ORT unchanged in toggle and temp adjust.
    Increase no NTP reboot time
    [HotTubUtils.cpp, controller.ino]
2025-02-20 Resurrected, calibrated, documented, bigger buttons
2025-02-22 watchdog reboot for display
    [display.ino]
2025-02-22 Upgrade libs - esp32, arduino_gfx
    All on latest (GFX on 1.5.0)
2025-02-24 Show reset reason, tweak display speed
    [core.cpp, core.h, display.ino, gfx.h]
2025-02-27 Fixed race condition, UI improvements
    [ESPNowUtils.cpp, display.ino]
2026-08-12 Bug fixes, native Celsius, persistent setpoint, new UI, PlatformIO, auth
    Bug fixes:
    - getDependentControl() fell off the end (UB) when a control had no
    dependency; now returns NULL.
    - cancelOverride() no longer trips checkBounds() with the disable sentinel.
    - Serial.printf("%s", String) misuse in WiFi setup and /configureWifi fixed
    with .c_str().
    - Incoming ESP-NOW commands are bounds-checked against control_id.
    Threading:
    - ESP-NOW receive callback (WiFi task) now only enqueues commands; they are
    drained and applied from loop() via a FreeRTOS queue, removing a race on
    control state.
    Temperature / units:
    - Native unit is now Celsius end-to-end (DS18B20 is natively C). Water temp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
    [HotTubUtils.cpp, HotTubUtils.h, TemperatureUtils.cpp, TemperatureUtils.h, controller.ino, display.ino, hot_tub_types.h]
2026-08-12 Make PlatformIO builds compile on Arduino-ESP32 3.x
    Both `pio run` builds now succeed (controller and display).
    - ESP-NOW callbacks are guarded for the Arduino-ESP32 core API changes:
    recv gained esp_now_recv_info (3.0), send switched to esp_now_send_info_t
    / wifi_tx_info_t (3.1). Guards keep 2.x, 3.0.x and 3.1+ all building.
    - controller: builds on the latest 3.x core (matches arduino-cli 3.3.8).
    - display: the vendored Arduino_GFX 1.5.3 has two SPI databus files that use
    the pre-3.x spiFrequencyToClockDiv() signature. The board is an RGB parallel
    panel, so those files are unused; a library.json srcFilter excludes them.
    Added -I${PROJECT_DIR} so LVGL (built as a lib) finds displa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
2026-08-12 Fix display RGB panel crash on IDF5; make heater schedule unit-aware
    Display crash-loop: on IDF 5.x, esp_lcd_new_rgb_panel() requires the frame
    buffer size (h_res*v_res) to be a multiple of bounce_buffer_size_px. The
    vendored Arduino_GFX hardcoded "40 * w", which does not divide 480x272, so
    init aborted (ESP_ERR_INVALID_ARG). Set bounce_buffer_size_px = 0 to disable
    the bounce buffer (DMA straight from the PSRAM framebuffer); fine for this
    low-bandwidth panel.
    Web schedule dialog is now temperature-unit aware for sensor-based controls:
    the range and the on/off setpoint fields display in the active unit (e.g.
    32-104F instead of the native 0-40C) and are converted back to Celsius on
    save, wit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
2026-08-12 Fix display touch: use GT911, not XPT2046
    The Sunton 4.3" ESP32-4827S043 has a GT911 capacitive controller, but touch.h
    was set to TOUCH_XPT2046 (resistive). The XPT2046 SPI pins (SCK=12/MISO=13/
    MOSI=11) are the SD-card pins on this board, so with no XPT2046 present the
    driver read stable garbage (~1650/1900 @z2755) that ts.touched() interpreted as
    a constant press — the cursor jittered in place at screen center.
    Switched touch.h to the GT911 config (matches Sunton's own demo for this board:
    SCL=20, SDA=19, INT=-1, RST=38) and swapped the touch library to TAMC_GT911.
    [touch.h]
2026-08-12 Fix ESP-NOW pairing: advertise the controller's real channel
    The controller left pairingData.channel echoing back whatever channel the
    display guessed in its pairing request. When they differed (e.g. display
    scanned ch 7 while the controller's STA was on ch 6), the display would
    addPeer()/esp_wifi_set_channel() onto the wrong channel, stop hearing the
    controller, time out after 60s and re-pair forever. Symptom: display stuck
    channel-hopping and only ever catching control 0 (pump).
    Set pairingData.channel = WiFi.channel() before sending the response so the
    peer locks onto the controller's actual channel.
    [ESPNowUtils.cpp]
2026-08-12 Fix GT911 touch on Arduino-ESP32 3.x: use bb_captouch
    TAMC_GT911 drives I2C with an API sequence that fails on the 3.x i2c-ng driver
    (i2cRead ESP_ERR_INVALID_STATE, "Only 7bit I2C addresses are supported"), so the
    controller never initializes and returns garbage coordinates (e.g. 617,513 on a
    480x272 panel) — flicker, no response. Switched the GT911 path to bitbank2's
    bb_captouch, which resets/addresses the chip and works with the 3.x I2C driver.
    Coordinate mapping (TOUCH_MAP_*) is unchanged since it reads the same GT911 output.
    [touch.h]
2026-08-12 Fix temperature not showing on display ("Hot Tub @f")
    LVGL's built-in printf has float formatting disabled (LV_SPRINTF_USE_FLOAT 0),
    so lv_label_set_text_fmt() with %f mis-parses — it printed the literal 'f' and
    mangled the varargs, so the water temperature never rendered (and the heater
    button / setpoint dialog were affected too). Build the banner string with the
    standard snprintf (float-capable) and use integer %d for the whole-degree labels.
    [display.ino]
2026-08-12 Fix display touch: revert to XPT2046, gate on PENIRQ pin
    The board is resistive (XPT2046), not GT911 — the earlier GT911/bb_captouch
    commits were a wrong turn. Reverted touch.h to the XPT2046 config and vendored
    the working XPT2046_Touchscreen library (copy of ~/Arduino/libraries).
    Phantom-touch fix: under this toolchain the library's latched tirqTouched()
    gets stuck set (isrWake never clears), so touch_touched() was polled constantly
    and read garbage z (~2700) -> a cursor jittering at screen centre. Gate
    touch_has_signal() on the real PENIRQ pin level (digitalRead == LOW) instead.
    Touch now registers correctly (verified: taps toggled blower/ozone/light).
    Calibration (TOUCH_MAP_*) still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
    [touch.h]
2026-08-13 Display: fix intermittent flicker, add optimistic button feedback
    Flicker: the RGB-panel crash fix had set bounce_buffer_size_px=0, so the panel
    DMA'd straight from PSRAM and underran under contention -> whole frame shifted
    ~10-20px left for a few ms every few seconds. Restore a bounce buffer sized to
    a frame divisor (w*16 = 7680, 130560/7680=17) to decouple refresh from PSRAM.
    Button feedback: pressing a control now turns its border white immediately
    ("sending"), then to the real state colour once the controller confirms via a
    status update whose value changed, or clears with a "No response" message after
    a 3s timeout. Removes the dead feel where nothing happened until the round-trip.
    Als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
    [display.ino]
2026-08-13 Revert internal temperature unit to Fahrenheit (keep C/F display toggle)
    Whole-degree Celsius was too coarse for the heater setpoint. Store/compare temps
    natively in Fahrenheit again (setpoint 0-104, u_int8_t, ~0.56C resolution, no
    ESP-NOW protocol change) and keep the temp_unit display preference: the display
    and web convert F->C only when Celsius is selected. Default unit is now F.
    Also revert the display bounce-buffer experiment (w*16 caused a double-image
    blur) back to 0, and the pixel clock back to 10MHz (6MHz didn't help the
    intermittent PSRAM-contention frame shift). That shift remains; the real fix is
    a double framebuffer (larger gfx.h rework) — TBD.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
    [HotTubUtils.cpp, TemperatureUtils.cpp, TemperatureUtils.h, controller.ino, display.ino, hot_tub_types.h]
2026-08-13 Display: double framebuffer via esp_lcd direct (fix frame-shift flicker)
    Arduino_GFX 1.5.3 has a single framebuffer, so the panel DMA'd the same PSRAM
    buffer LVGL was writing -> intermittent ~10-20px horizontal frame shift under
    contention. Rewrote gfx_init() to drive the RGB panel directly through esp_lcd
    with num_fbs=2: the two PSRAM framebuffers are LVGL's draw buffers (full_refresh),
    the panel scans one while LVGL renders the other, and my_disp_flush() swaps via
    esp_lcd_panel_draw_bitmap synced to an on_vsync callback (tear-free). Pins,
    timings and RGB565 pin order are copied exactly from the Arduino_GFX config
    (LV_COLOR_16_SWAP=0, non-big-endian); the gfx object is kept only for
    width()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
    [gfx.h]
2026-08-13 Revert double-framebuffer rework (esp_lcd swap didn't decouple on this panel)
    The esp_lcd num_fbs=2 approach (a89b49f) did not achieve a working buffer swap
    on this board/IDF: full_refresh showed a visible full-screen white repaint, and
    direct_mode still flickered plus an occasional rightward shift. Without eyes on
    the panel I can't debug the swap timing, so restore the Arduino_GFX single-fb
    baseline (occasional minor frame shift, which the user found tolerable).
    Flicker elimination remains a future task — likely a known-good board-specific
    gfx setup or LVGL port, debugged interactively.
    [gfx.h]
2026-08-13 Debounce control button taps (resistive panel double-fire)
    The XPT2046 panel sometimes reports a single tap as press-release-press, so LVGL
    fired two CLICKED events and the control toggled on then off. Ignore a second
    click on the same control within 350ms.
2026-08-13 Display: modern dark-card theme
    Apply LVGL dark theme + slate background; restyle control cards as rounded,
    state-coloured tiles (OFF dark / ON red / pump LOW amber, HIGH orange / heater
    dark with warm setpoint) with name top-left, large value bottom-left, override
    chip bottom-right. Value (ON/OFF) now shown for off-on controls too. Recolour
    the top banner: muted name + cyan water temperature. Matches the approved mockup.
2026-08-13 Dark-theme the heater setpoint dialog; swap OK/Close, center labels
    The setpoint dialog was built before lv_theme_default_init ran, so its buttons
    kept the old light styling — apply the dark theme before createSensorBasedDialog().
    Also swap OK (now right column) and Close (now left column), and center the OK,
    Close, and Revert button labels.
    [display.ino]
2026-08-13 Heater: red card when heating, temporary setpoint override, dark dialog buttons
    - Heater card turns red when actively heating (e_value>0), dark with warm setpoint
    when idle — was always grey.
    - Setpoint dialog buttons get an explicit dark style (the theme filled them cyan,
    which read as the old blue).
    - Revert the heater setpoint to a TEMPORARY override (scheduleOverride) instead of
    a persistent change: +/- now sets the temperature for the default-override window
    and reverts to the scheduled setpoint (normalValueOn, set via the web schedule
    dialog). The card shows the ORT countdown like other controls; the confirm message
    states the duration.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
    [HotTubUtils.cpp, display.ino]
2026-08-13 Make the network activity indicators less jarring
    The receive (download) symbol blinked on every ~1s status message. Make it a
    steady, dimmed symbol while the link is healthy (a message arrived in the last
    few seconds) and hide it only if the link drops — no more 1Hz blink. The send
    (upload) symbol stays a brief flash on an actual send. Both dimmed to a muted
    grey via label recolor so they recede next to the clock.
2026-08-13 Move display libs to PlatformIO registry deps; de-bloat the repo
    lvgl and Arduino_GFX were vendored under libs/ (gitignored, ~580MB with .git),
    carrying local patches that made them impossible to commit cleanly. Replace both
    with registry lib_deps:
    - lvgl @ 8.3.11 (matches the vendored version and our lv_conf.h)
    - GFX Library for Arduino @ ^1.6.7
    Arduino_GFX >=1.6.7 exposes bounce_buffer_size_px as a constructor parameter and
    does its own Cache_WriteBack to PSRAM after drawing, so the anti-flicker bounce
    buffer (480*34 px) is now configured from gfx.h with no library patch — this was
    the last reason the GFX copy had to be vendored.
    XPT2046_Touchscreen keeps a one-line local patch (500kH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
    [gfx.h]
2026-08-13 removed animations to avoid screen corruption
    [display.ino]
2026-08-13 fix extra touch when closing dialog, fix screen corruption
    [display.ino, gfx.h]
2026-08-15 removed arduino-cli
2026-08-18 Disable heater on invalid sensor reading
